tfuruha/EV_Logger_adalogger_202305/README.md

# EV_Logger_adalogger_202305
## board type
 [Adafruit Feather M0 Adalogger](https://learn.adafruit.com/adafruit-feather-m0-adalogger)
## Other required libraries
GPS: [tinyGPS++](http://arduiniana.org/libraries/tinygpsplus/)  
OLED: [u8g2](https://github.com/olikraus/u8g2/wiki)  
Use float type in springf: [LibPrintf](https://github.com/embeddedartistry/arduino-printf)  
Watch Dog Timer: [wdt_samd21](https://github.com/gpb01/wdt_samd21)
