tfuruha/EV_Logger_adalogger_202305/schematic/EV_DriverPW_RevC.pdf

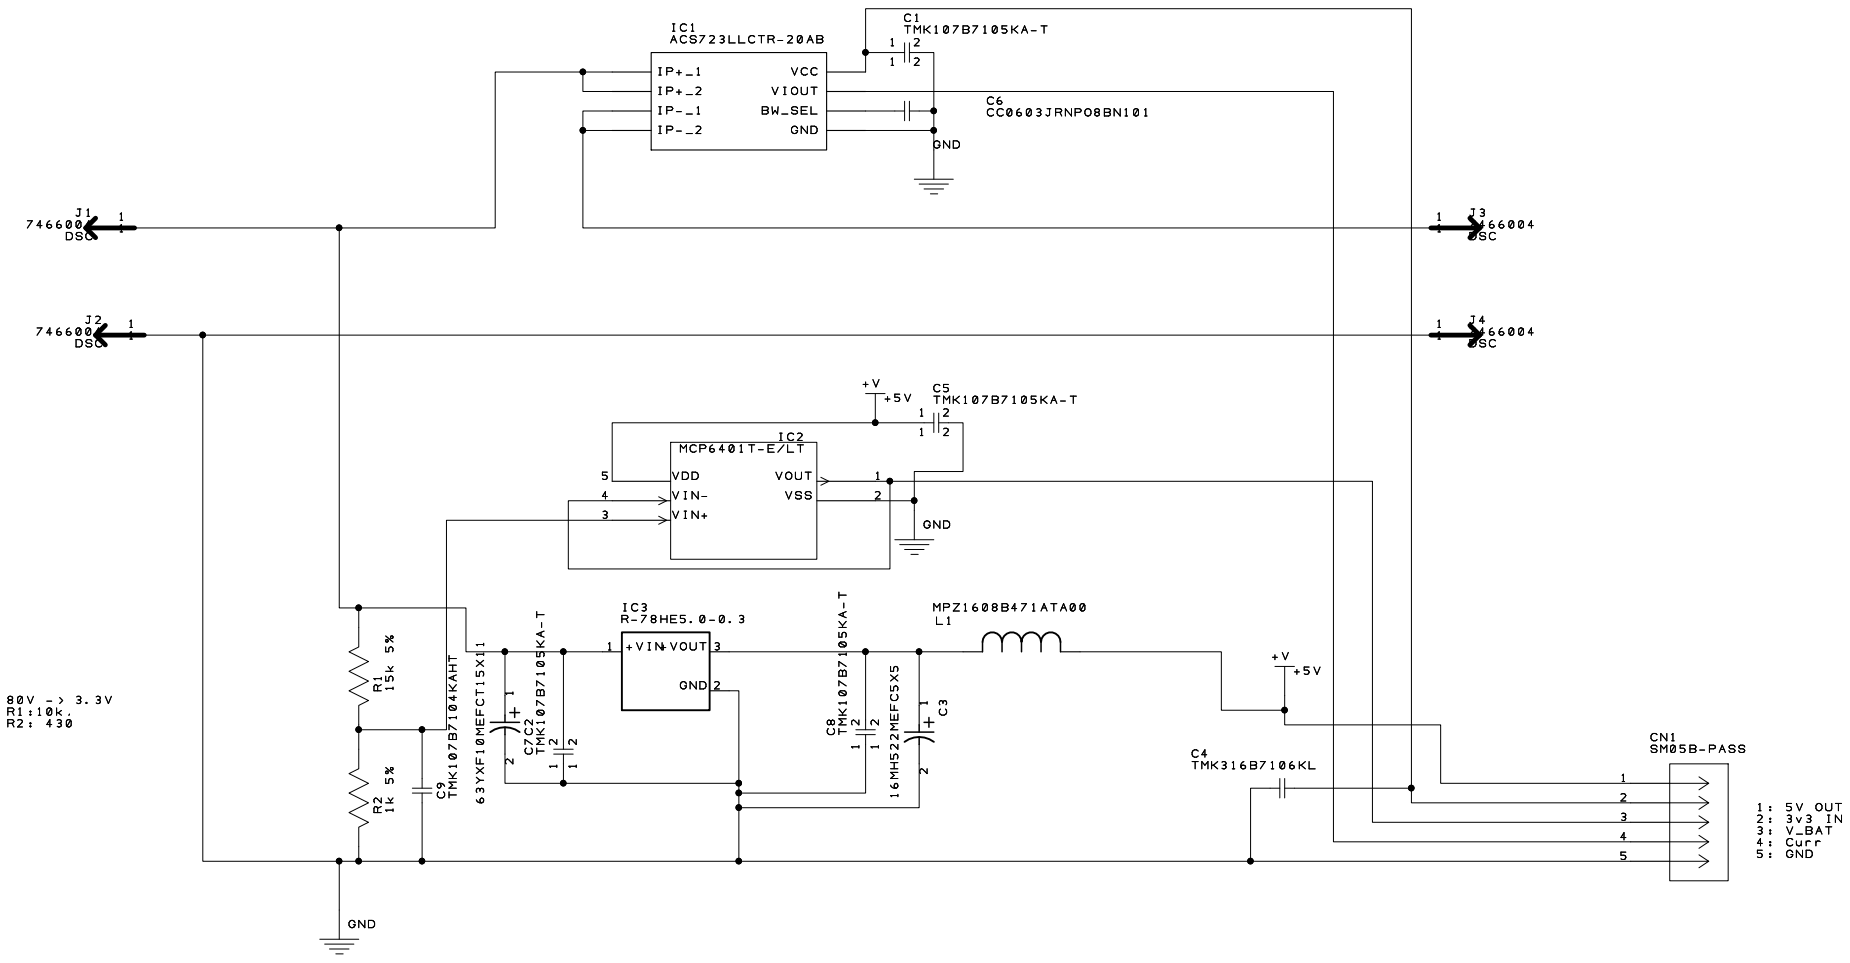
[picture p1: page 1]
