tfuruha/EV_Logger_adalogger_202305/schematic/EVLogger_rev1.pdf

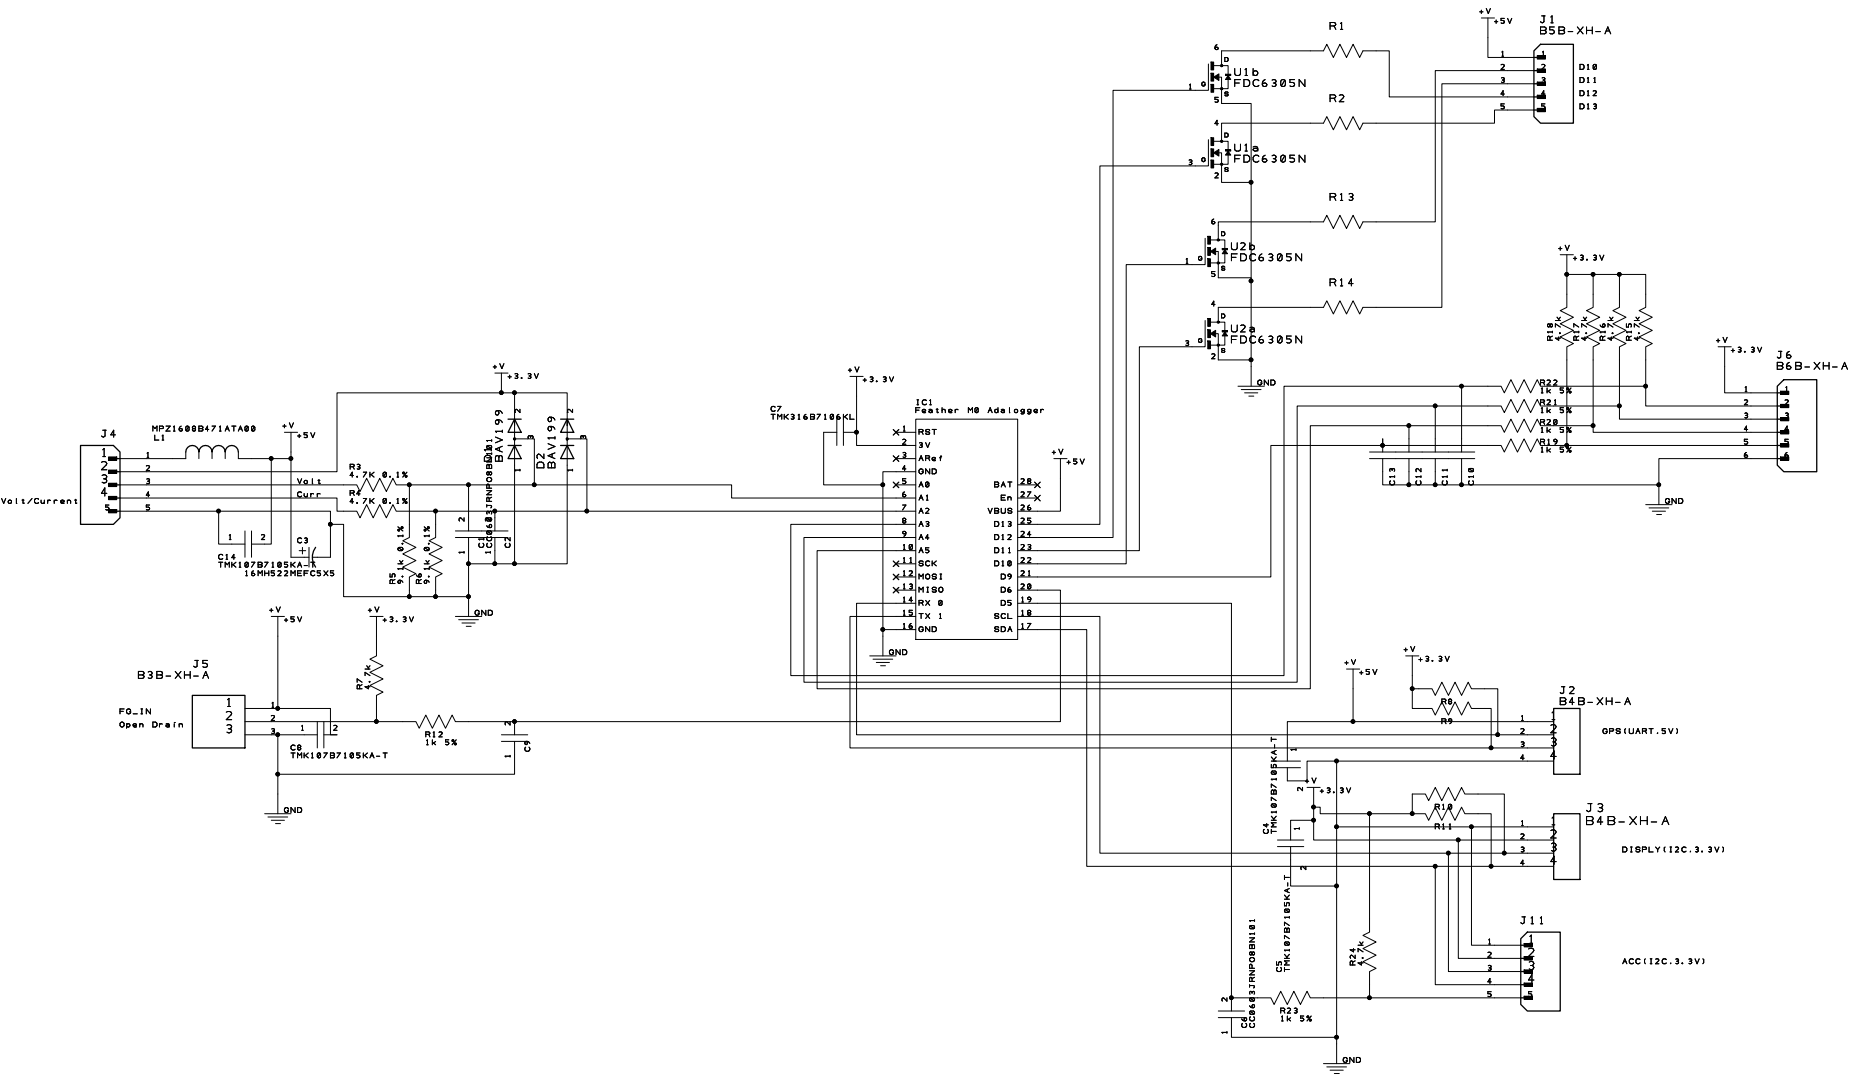
[picture p2: page 1]
