tfuruha/EV_Logger_adalogger_202305/todo2023.txt

2023の変更点
・使用センサ変更(MPU6050→ADXL345)
 *AccSensorの変更
　ライブラリの変更
　割込みピンの追加(→D5)
 *電流センサ
　変換式変更
　0点補正追加
 *電圧センサ
　変換式変更
 *スピード計測
　読み込みピンの変更(→D6)
