tfuruha/EV_Logger_adalogger_202305/(commit log)

2023-06-25 Added schematics
2023-07-16 Update EV_Logger_adalogger_202305.ino
    初回の電流表示値が下限値だったので修正。
    ・電流の移動平均バッファ初期値の修正
    ・実値変換、積算処理をADCサンプリングが平均化回数以上で実施するように変更
    (ADCサンプリングする前に実値変換、積分処理してた？)
    画面表示フリーズ対策
    ・画面処理時に車速パルス割込みを無効(効果は不明)
    OLEDの電源入力にMLCC(22uF 10V)を追加
    [EV_Logger_adalogger_202305.ino]
2023-07-17 起動ステップ見直し
    起動画面の追加(u8x8利用)
    Serial 確立待ちのロジック変更
    tinyADXL345
    SetOffsetRegADXL345() デバッグ出力の分離
    [HW] I2Cプルアップ抵抗 4.7k→1.2k
